Blisart/InkCast/inkcast/config.h

#pragma once

// ============================================================
// Секреты (WiFi, API ключи) вынесены в secrets.h (в .gitignore).
// Скопируй secrets.h.example → secrets.h и впиши свои значения.
// Или настрой всё через web-админку после прошивки.
// ============================================================
#include "secrets.h"

// ============================================================
// Defaults — используются на первой прошивке (NVS пуст).
// После сохранения в админке runtime-настройки имеют приоритет.
// ============================================================

#define WIFI_TIMEOUT_SEC 15
#define OWM_CITY      "Москва"       // название для дисплея
#define OWM_LAT       "55.7558"      // широта (Москва)
#define OWM_LON       "37.6176"      // долгота (Москва)
#define OWM_LANG      "ru"
#define OWM_UNITS     "metric"  // metric | imperial

// ============================================================
// Deep Sleep
// ============================================================
#define SLEEP_DURATION_MIN   120  // обновление раз в 2 часа
#define DEBUG_JUMPER_PIN     6    // замкнут на GND = режим отладки (не спим)

// ============================================================
// SPI пины для DESPI-C02 → ESP32-S3
// Проверь распиновку своей платы!
// ============================================================
#define EPD_CS    10
#define EPD_DC    9
#define EPD_RST   8
#define EPD_BUSY  7
#define EPD_CLK   12
#define EPD_MOSI  11

// ============================================================
// Батарея — аналоговый вход через делитель напряжения
// T-Energy-S3 V1.0: BATTERY_ADC_DATA -> GPIO3, делитель 1:2
// ============================================================
#define BAT_ADC_PIN       3
#define BAT_DIVIDER_RATIO 2.0f
#define BAT_MIN_V         3.2f
#define BAT_MAX_V         4.2f

// ============================================================
// Часовой пояс — FALLBACK
// ------------------------------------------------------------
// Реальное смещение приходит из ответа OWM (поле timezone_offset,
// уже с учётом DST) и устанавливается через setUtcOffsetSec()
// в weather_api.cpp. Это значение используется только до первого
// успешного запроса (например, для NTP-настройки в .ino перед
// fetchWeather()) и при сборке тестов.
// Москва: +3 = 10800
// ============================================================
#define UTC_OFFSET_SEC 10800

// ============================================================
// Дисплей
// ============================================================
#define DISPLAY_WIDTH  800
#define DISPLAY_HEIGHT 480
