Blisart/InkCast/inkcast/icons.h

#ifndef ICONS_H
#define ICONS_H

#include <Arduino.h>

// ============================================================================
// Иконки погоды для e-ink дисплея (GxEPD2 / Adafruit_GFX drawBitmap)
// Формат: row-major, MSB first, 1 = чёрный, 0 = белый
// Каждая строка дополнена до границы байта
// ============================================================================

// ----------------------------------------------------------------------------
// 48x48 — крупные иконки текущей погоды (6 байт на строку)
// ----------------------------------------------------------------------------

// Солнце с лучами
static const unsigned char icon48_clear_day[] PROGMEM = {
  0x00, 0x00, 0x01, 0x80, 0x00, 0x00,  // ........______##______..........
  0x00, 0x00, 0x01, 0x80, 0x00, 0x00,
  0x00, 0x00, 0x01, 0x80, 0x00, 0x00,
  0x00, 0x00, 0x01, 0x80, 0x00, 0x00,
  0x00, 0x00, 0x01, 0x80, 0x00, 0x00,
  0x00, 0x18, 0x01, 0x80, 0x18, 0x00,  // row 5
  0x00, 0x1C, 0x00, 0x00, 0x38, 0x00,
  0x00, 0x0E, 0x00, 0x00, 0x70, 0x00,
  0x00, 0x07, 0x00, 0x00, 0xE0, 0x00,
  0x00, 0x03, 0x80, 0x01, 0xC0, 0x00,
  0x00, 0x01, 0x80, 0x01, 0x80, 0x00,  // row 10
  0x00, 0x00, 0x07, 0xE0, 0x00, 0x00,
  0x00, 0x00, 0x1F, 0xF8, 0x00, 0x00,
  0x00, 0x00, 0x3F, 0xFC, 0x00, 0x00,
  0x00, 0x00, 0x7F, 0xFE, 0x00, 0x00,
  0x00, 0x00, 0xFF, 0xFF, 0x00, 0x00,  // row 15
  0x00, 0x00, 0xFF, 0xFF, 0x00, 0x00,
  0x00, 0x01, 0xFF, 0xFF, 0x80, 0x00,
  0x00, 0x01, 0xFF, 0xFF, 0x80, 0x00,
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
static const unsigned char icon16_sunset[] PROGMEM = {
  0x00, 0x00,
  0x01, 0x80,
  0x01, 0x80,
  0x01, 0x80,
  0x07, 0xE0,
  0x03, 0xC0,
  0x01, 0x80,
  0x03, 0xC0,
  0x0F, 0xF0,
  0x1F, 0xF8,
  0x3F, 0xFC,
  0x3F, 0xFC,
  0x1F, 0xF8,
  0x0F, 0xF0,
  0x7F, 0xFE,
  0xFF, 0xFF
};

// Капля воды (влажность)
static const unsigned char icon16_raindrop[] PROGMEM = {
  0x01, 0x80,
  0x01, 0x80,
  0x03, 0xC0,
  0x03, 0xC0,
  0x07, 0xE0,
  0x07, 0xE0,
  0x0F, 0xF0,
  0x0F, 0xF0,
  0x1F, 0xF8,
  0x1F, 0xF8,
  0x3F, 0xFC,
  0x3F, 0xFC,
  0x3F, 0xFC,
  0x1F, 0xF8,
  0x0F, 0xF0,
  0x03, 0xC0
};

// Солнце 28x28 (контур 3px, 8 лучей 2px, для счётчика солнечных дней)
// Хранится в 32-битной ширине (4 байта/строку)
static const unsigned char icon28_sun[] PROGMEM = {
  0x00, 0x00, 0x00, 0x00,  // row 0
  0x00, 0x00, 0x00, 0x00,  // row 1
  0x00, 0x01, 0x80, 0x00,  // row 2  — верхний луч (2px)
  0x00, 0x01, 0x80, 0x00,  // row 3
  0x00, 0x01, 0x80, 0x00,  // row 4
  0x01, 0x81, 0x81, 0x80,  // row 5  — диагональные (2px) + верхний луч
  0x01, 0xC0, 0x03, 0x80,  // row 6
  0x00, 0xCF, 0xF3, 0x00,  // row 7  — диаг + круг верх
  0x00, 0x1F, 0xF8, 0x00,  // row 8  — контур круга (3px толщина)
  0x00, 0x3F, 0xFC, 0x00,  // row 9
  0x00, 0x78, 0x1E, 0x00,  // row 10
  0x00, 0x70, 0x0E, 0x00,  // row 11
  0x00, 0x70, 0x0E, 0x00,  // row 12
  0x0F, 0x70, 0x0E, 0x78,  // row 13 — боковые лучи (3px) + контур
  0x0F, 0x70, 0x0E, 0x78,  // row 14
  0x00, 0x70, 0x0E, 0x00,  // row 15
  0x00, 0x70, 0x0E, 0x00,  // row 16
  0x00, 0x78, 0x1E, 0x00,  // row 17
  0x00, 0x3F, 0xFC, 0x00,  // row 18
  0x00, 0x1F, 0xF8, 0x00,  // row 19
  0x00, 0xCF, 0xF3, 0x00,  // row 20 — диаг + круг низ
  0x01, 0xC0, 0x03, 0x80,  // row 21
  0x01, 0x80, 0x01, 0x80,  // row 22 — диагональные + нижний луч
  0x00, 0x01, 0x80, 0x00,  // row 23
  0x00, 0x01, 0x80, 0x00,  // row 24
  0x00, 0x01, 0x80, 0x00,  // row 25 — нижний луч
  0x00, 0x01, 0x80, 0x00,  // row 26
  0x00, 0x00, 0x00, 0x00   // row 27
};

// Размеры 16x16 иконок
#define ICON16_WIDTH  16
#define ICON16_HEIGHT 16

// ----------------------------------------------------------------------------
// 24x24 — иконки восход/закат/капля для текущей погоды (3 байта на строку)
// Стиль: полукруг солнца + лучи над горизонтом, стрелка вверх/вниз
// ----------------------------------------------------------------------------

// Восход: полукруг солнца с лучами над горизонтом, широкая стрелка вверх по центру
static const unsigned char icon24_sunrise[] PROGMEM = {
  0x00, 0x18, 0x00,  // row 0  — кончик стрелки (2px)
  0x00, 0x3C, 0x00,  // row 1
  0x00, 0x7E, 0x00,  // row 2
  0x00, 0xFF, 0x00,  // row 3
  0x01, 0xFF, 0x80,  // row 4  — основание стрелки (широкое)
  0x03, 0xFF, 0xC0,  // row 5
  0x00, 0x18, 0x00,  // row 6  — стержень (2px)
  0x00, 0x18, 0x00,  // row 7
  0x00, 0x18, 0x00,  // row 8
  0x20, 0x00, 0x04,  // row 9  — боковые лучи
  0x30, 0x00, 0x0C,  // row 10
  0x18, 0x00, 0x18,  // row 11
  0x00, 0x00, 0x00,  // row 12
  0x00, 0x7E, 0x00,  // row 13 — верх полукруга
  0x01, 0xFF, 0x80,  // row 14
  0x03, 0xFF, 0xC0,  // row 15
  0x07, 0xFF, 0xE0,  // row 16
  0x07, 0xFF, 0xE0,  // row 17
  0x0F, 0xFF, 0xF0,  // row 18
  0x0F, 0xFF, 0xF0,  // row 19 — низ полукруга
  0xFF, 0xFF, 0xFF,  // row 20 — горизонт (жирная линия)
  0xFF, 0xFF, 0xFF,  // row 21
  0x00, 0x00, 0x00,  // row 22
  0x00, 0x00, 0x00   // row 23
};

// Закат: полукруг солнца с лучами над горизонтом, широкая стрелка вниз по центру
static const unsigned char icon24_sunset[] PROGMEM = {
  0x00, 0x18, 0x00,  // row 0  — стержень (2px)
  0x00, 0x18, 0x00,  // row 1
  0x00, 0x18, 0x00,  // row 2
  0x03, 0xFF, 0xC0,  // row 3  — основание стрелки (широкое)
  0x01, 0xFF, 0x80,  // row 4
  0x00, 0xFF, 0x00,  // row 5
  0x00, 0x7E, 0x00,  // row 6
  0x00, 0x3C, 0x00,  // row 7
  0x00, 0x18, 0x00,  // row 8  — кончик стрелки
  0x20, 0x00, 0x04,  // row 9  — боковые лучи
  0x30, 0x00, 0x0C,  // row 10
  0x18, 0x00, 0x18,  // row 11
  0x00, 0x00, 0x00,  // row 12
  0x00, 0x7E, 0x00,  // row 13 — верх полукруга
  0x01, 0xFF, 0x80,  // row 14
  0x03, 0xFF, 0xC0,  // row 15
  0x07, 0xFF, 0xE0,  // row 16
  0x07, 0xFF, 0xE0,  // row 17
  0x0F, 0xFF, 0xF0,  // row 18
  0x0F, 0xFF, 0xF0,  // row 19 — низ полукруга
  0xFF, 0xFF, 0xFF,  // row 20 — горизонт (жирная линия)
  0xFF, 0xFF, 0xFF,  // row 21
  0x00, 0x00, 0x00,  // row 22
  0x00, 0x00, 0x00   // row 23
};

// Капля воды 24x24 (контур 3px, полая внутри)
static const unsigned char icon24_raindrop[] PROGMEM = {
  0x00, 0x00, 0x00,  // row 0
  0x01, 0xC0, 0x00,  // row 1  — кончик (3px)
  0x01, 0xC0, 0x00,  // row 2
  0x03, 0xE0, 0x00,  // row 3
  0x03, 0xE0, 0x00,  // row 4
  0x07, 0xF0, 0x00,  // row 5
  0x06, 0x30, 0x00,  // row 6  — контур расширяется
  0x0E, 0x38, 0x00,  // row 7
  0x0C, 0x18, 0x00,  // row 8
  0x1C, 0x1C, 0x00,  // row 9
  0x18, 0x0C, 0x00,  // row 10
  0x38, 0x0E, 0x00,  // row 11
  0x30, 0x06, 0x00,  // row 12
  0x70, 0x07, 0x00,  // row 13
  0x60, 0x03, 0x00,  // row 14
  0x60, 0x03, 0x00,  // row 15
  0x60, 0x03, 0x00,  // row 16
  0x70, 0x07, 0x00,  // row 17
  0x70, 0x07, 0x00,  // row 18
  0x38, 0x0E, 0x00,  // row 19
  0x3C, 0x1E, 0x00,  // row 20
  0x1F, 0xFC, 0x00,  // row 21
  0x0F, 0xF8, 0x00,  // row 22
  0x03, 0xE0, 0x00   // row 23
};

// ============================================================================
// Маппинг OWM icon code -> bitmap
// ============================================================================

// Маппинг OWM icon code -> иконка 48x48 (текущая погода)
inline const unsigned char* getWeatherIcon48(const String& iconCode) {
  if (iconCode == "01d")                          return icon48_clear_day;
  if (iconCode == "01n")                          return icon48_clear_night;
  if (iconCode == "02d" || iconCode == "02n")     return icon48_few_clouds;
  if (iconCode == "03d" || iconCode == "03n")     return icon48_cloudy;
  if (iconCode == "04d" || iconCode == "04n")     return icon48_overcast;
  if (iconCode == "09d" || iconCode == "09n")     return icon48_heavy_rain;
  if (iconCode == "10d" || iconCode == "10n")     return icon48_rain;
  if (iconCode == "11d" || iconCode == "11n")     return icon48_thunderstorm;
  if (iconCode == "13d" || iconCode == "13n")     return icon48_snow;
  if (iconCode == "50d" || iconCode == "50n")     return icon48_mist;
  return icon48_cloudy; // fallback
}

// Маппинг OWM icon code -> иконка 32x32 (прогноз)
inline const unsigned char* getWeatherIcon32(const String& iconCode) {
  if (iconCode == "01d")                          return icon32_clear_day;
  if (iconCode == "01n")                          return icon32_clear_night;
  if (iconCode == "02d" || iconCode == "02n")     return icon32_few_clouds;
  if (iconCode == "03d" || iconCode == "03n")     return icon32_cloudy;
  if (iconCode == "04d" || iconCode == "04n")     return icon32_overcast;
  if (iconCode == "09d" || iconCode == "09n")     return icon32_heavy_rain;
  if (iconCode == "10d" || iconCode == "10n")     return icon32_rain;
  if (iconCode == "11d" || iconCode == "11n")     return icon32_thunderstorm;
  if (iconCode == "13d" || iconCode == "13n")     return icon32_snow;
  if (iconCode == "50d" || iconCode == "50n")     return icon32_mist;
  return icon32_cloudy; // fallback
}

#endif // ICONS_H
