Blisart/InkCast/inkcast/rubik_fonts_u8g2.h

#pragma once

// Rubik шрифты в формате U8g2 (ASCII + кириллица + °)
// Сгенерировано из Rubik-Variable.ttf
// Диапазоны: 0x20-0x7E, 0xB0(°), 0x401(Ё), 0x410-0x44F(А-я), 0x451(ё)

/*
  Fontname: -Rubik-14
  Copyright: (null)
  Glyphs: 162/162
  BBX Build Mode: 0
*/
const uint8_t rubik_u8g2_14[2340] U8G2_FONT_SECTION("rubik_u8g2_14") = 
  "\242\0\3\3\4\5\2\5\5\17\20\377\375\12\375\13\376\1\246\3S\4\317 \5\0\214\23!\7\242\206"
  "\24O\4\42\10\64\276\26\225\211\0#\22\210\216Z\22YHr\10\245\211B\207\203$$\2$\20\307"
  "~y\301\312AF-Vi\225I\61\6%\26\251\206\33\303\211H\22\312\242\64\21Kf\21I(\213"
  "H\62\34&\24\251\206ZS\211\60$\224\10\211\245\210\244\22\243\210X\6'\10\62\276\23\223\10\0("
  "\15\324vU\222\222(\226\233H&\32)\15\324t\25\242\231H\226'\25\13\0*\11E\266\66\242\212"
  "\210\2+\13\207\206y\341\264[\70\33\0,\10\62~\24\223\10\0-\7%\236\27\207\1.\6\42\206"
  "\24\4/\17\307|\267\322\250\64\252\32\225F\25\245\0\60\15\247\206Y\224\203\214o\225I\5\0\61\13"
  "\245\204v\242\211d\24\314\7\62\17\247\206\71$\213L*\24\316\204\302\303\1\63\15\247\206\31\217\212\303"
  "\352\260\62\251\0\64\22\251\204\271\342)Q\42\224\310D\242\303\201*\27\1\65\20\247\206\71\25\213Tj"
  "\221Ii\225I\5\0\66\17\247\206y\302\241\220d\221\261U&\25\0\67\15\247\204\30\257B\251\242T"
  "(\225\1\70\20\247\206\71\225\203\214&\251\34d\264\222\244\2\71\20\250\204Y\64\223\214(\221I\214T"
  "\325\31\0:\7r\206\24d\2;\10\202~\24\344\12\0<\14\226\204\267A\331d\64\134\225\6=\11"
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
  "\20{\30\362\14HD\341\60E(P\21\12T\204\2\25\241@E\60N!\216R\210h@\305!\17"
  ")J\61\214R\10\303\24\302\60E\60N\21\12\264\240\2\4Q<\325g\20KH\251\30\5*F\201"
  "\212Q\240b\24\37,$\212AO\201\210a\214Q #\30\310\10F*\202\221\212@\205\17|\301x"
  "&h\34C\30\346\30QyN\223\24\3\0\0";
