Blisart/InkCast/(commit log)

2026-05-18 fix: refine Open-Meteo cloud icon by low+mid cover, ignore high cirrus
    [open_meteo_map.h, weather_api.cpp]
2026-06-10 fix: connect to OpenWeatherMap without CA pinning (ISRG pin no longer matches ZeroSSL cert)
    [weather_api.cpp]
